rossgk/GPOD/GPOD_Stand/wdStdMake_6.jpg

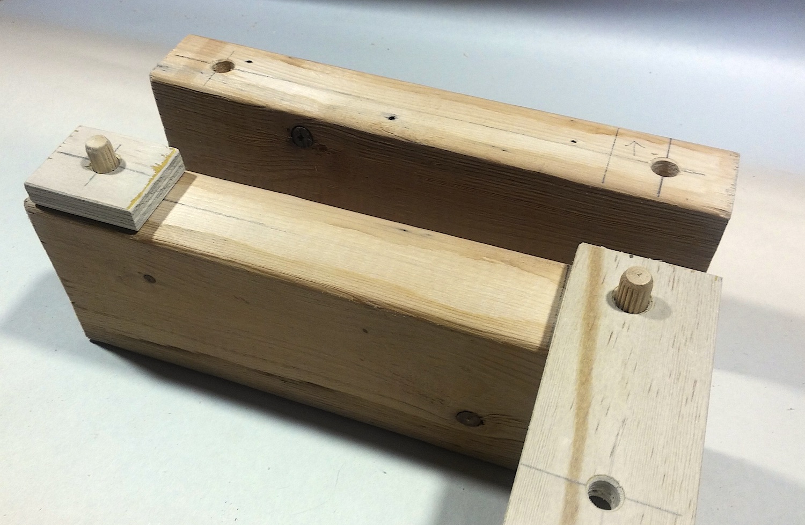
GPOD_Stand/wdStdMake_6.jpg
