rossgk/GPOD/GPOD_Stand/wdStdMake_2.jpg

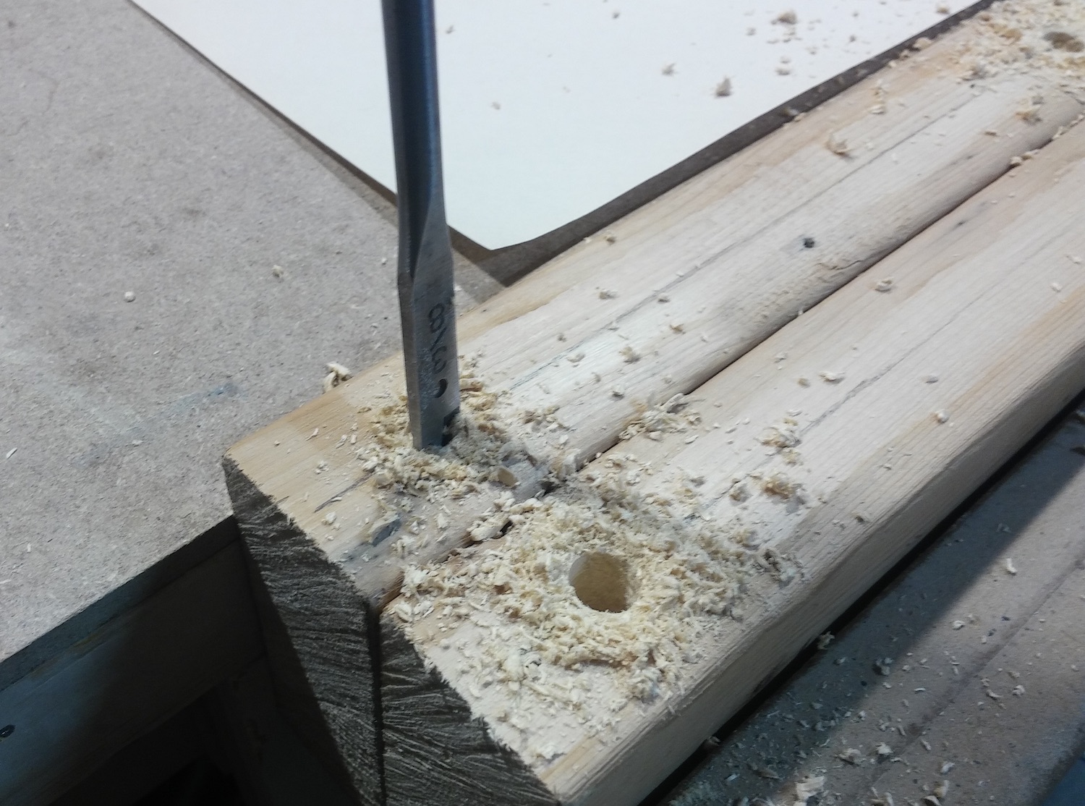
GPOD_Stand/wdStdMake_2.jpg
