rossgk/GPOD/Schem_GPOD_v1.3.pdf

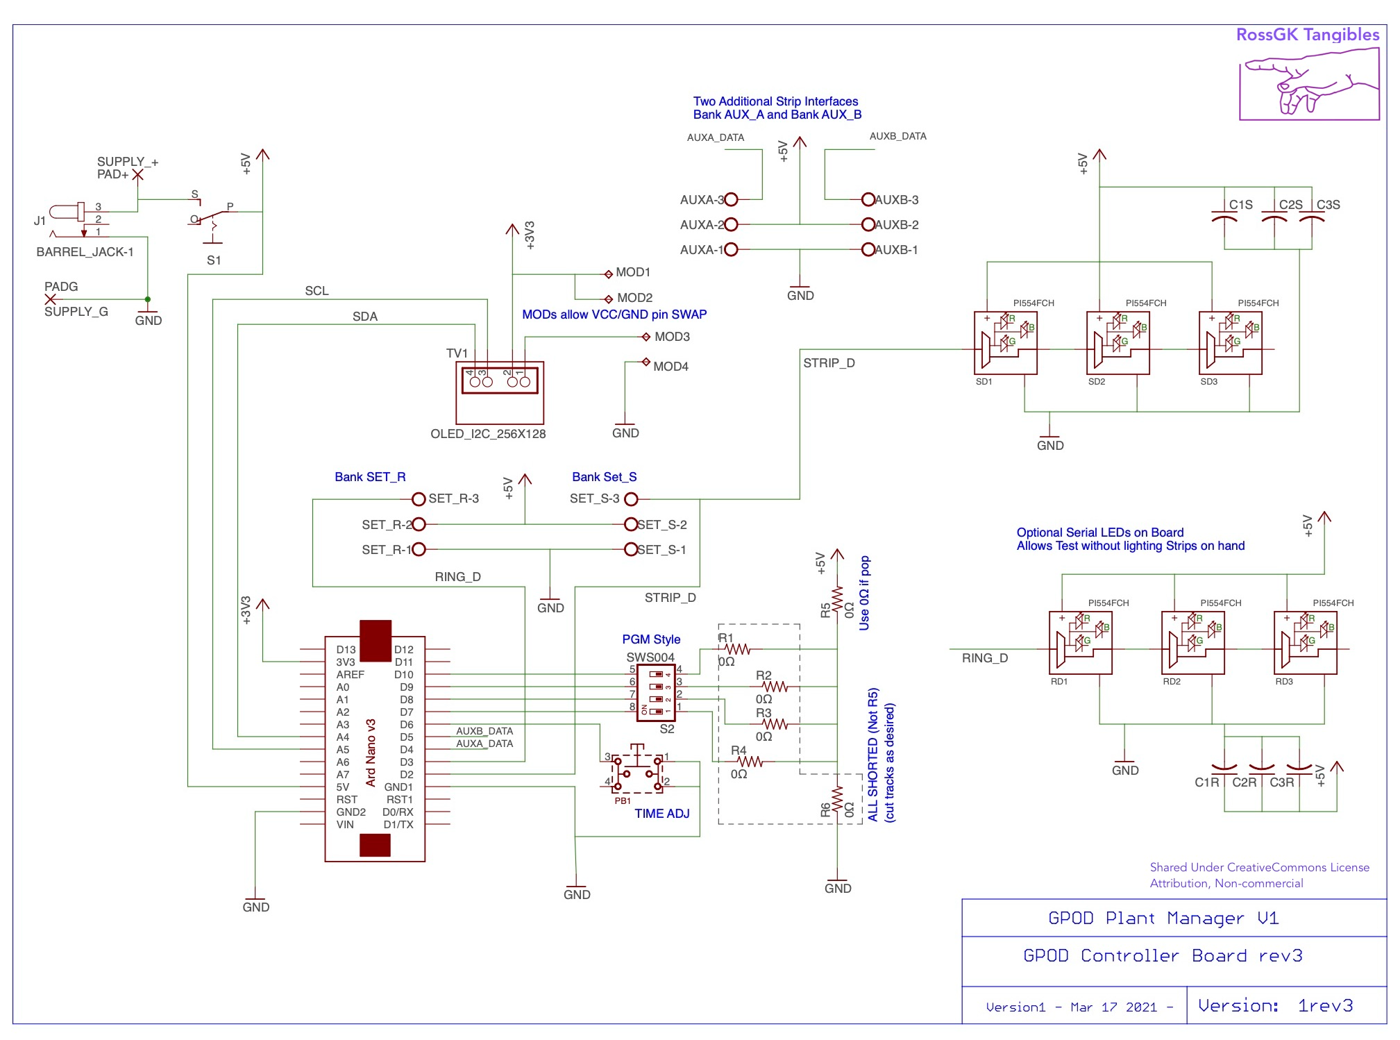
[picture p3: page 1]
