rossgk/GPOD/GPOD_Stand/wdStdMake_1.jpg

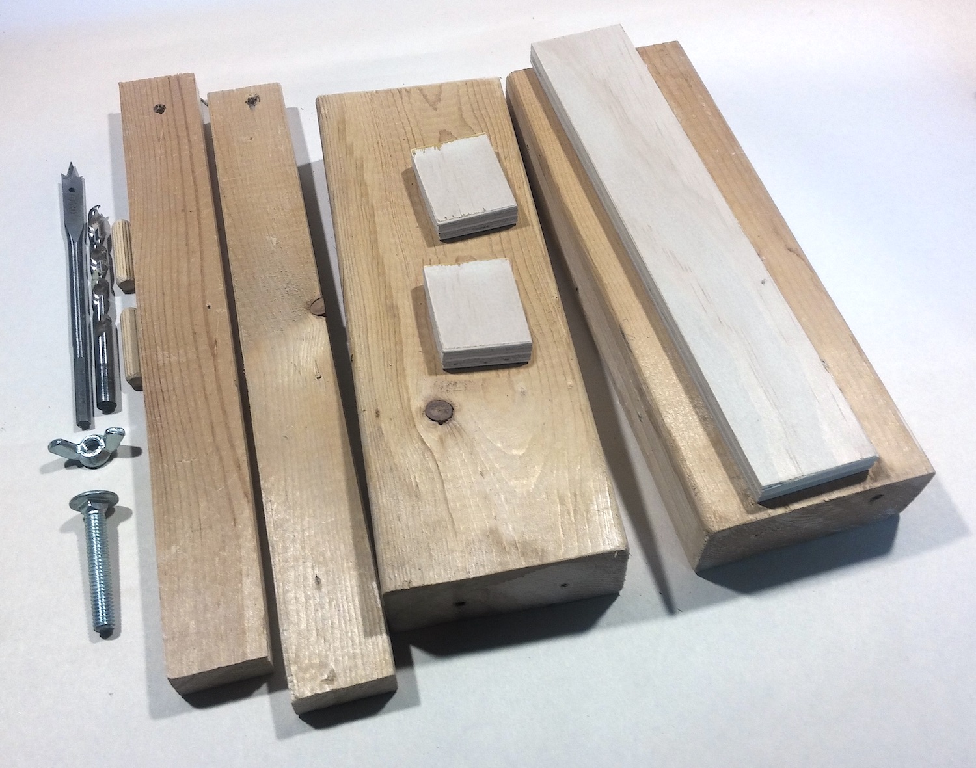
GPOD_Stand/wdStdMake_1.jpg
