rossgk/GPOD/GPOD_Stand/wdStdMake_3.jpg

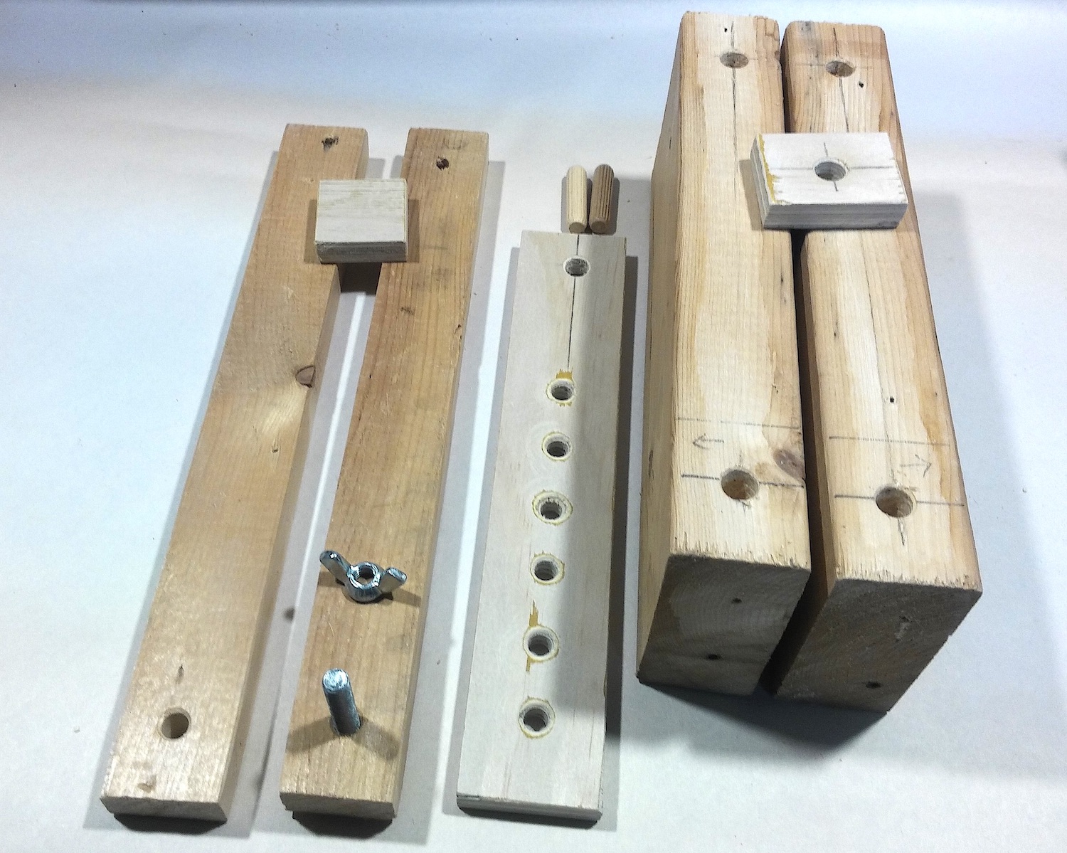
GPOD_Stand/wdStdMake_3.jpg
