rossgk/GPOD/GPOD_Stand/wdStdMake_4.jpg

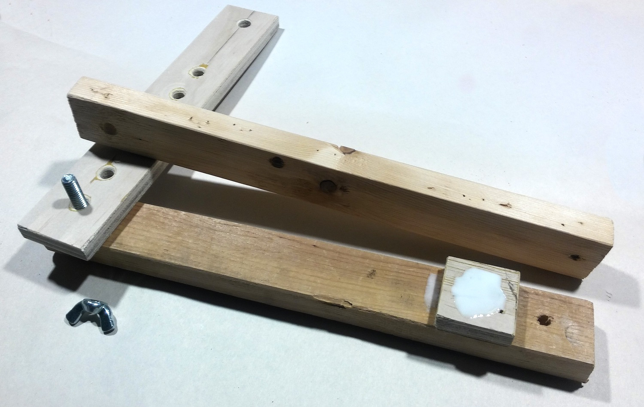
GPOD_Stand/wdStdMake_4.jpg
