rossgk/GPOD/GPOD_Stand/wdStdMake_5.jpg

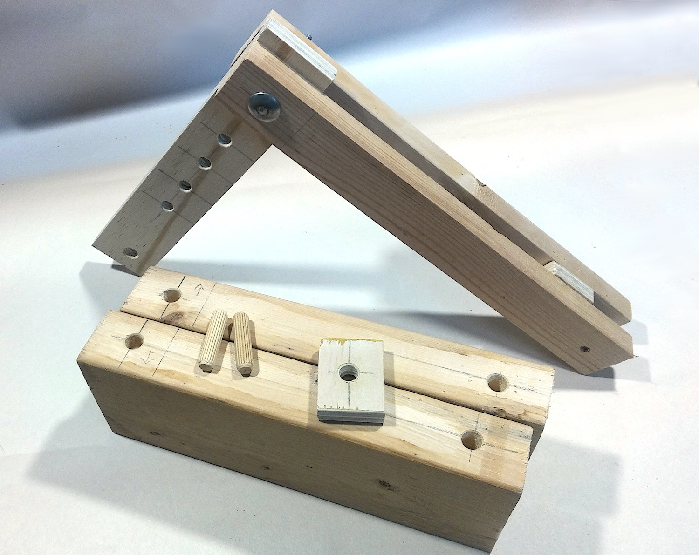
GPOD_Stand/wdStdMake_5.jpg
