rossgk/GPOD/GPOD_Stand/wdStdMake_7.jpg

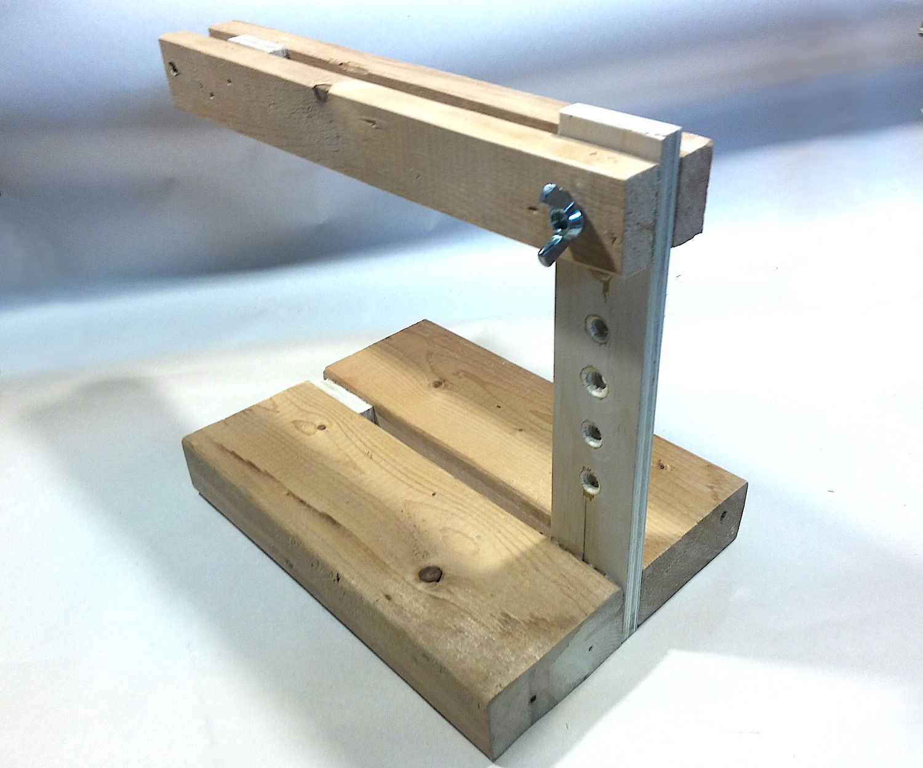
GPOD_Stand/wdStdMake_7.jpg
