rossgk/GPOD/GPOD_Stand/wdStdMake_8.jpg

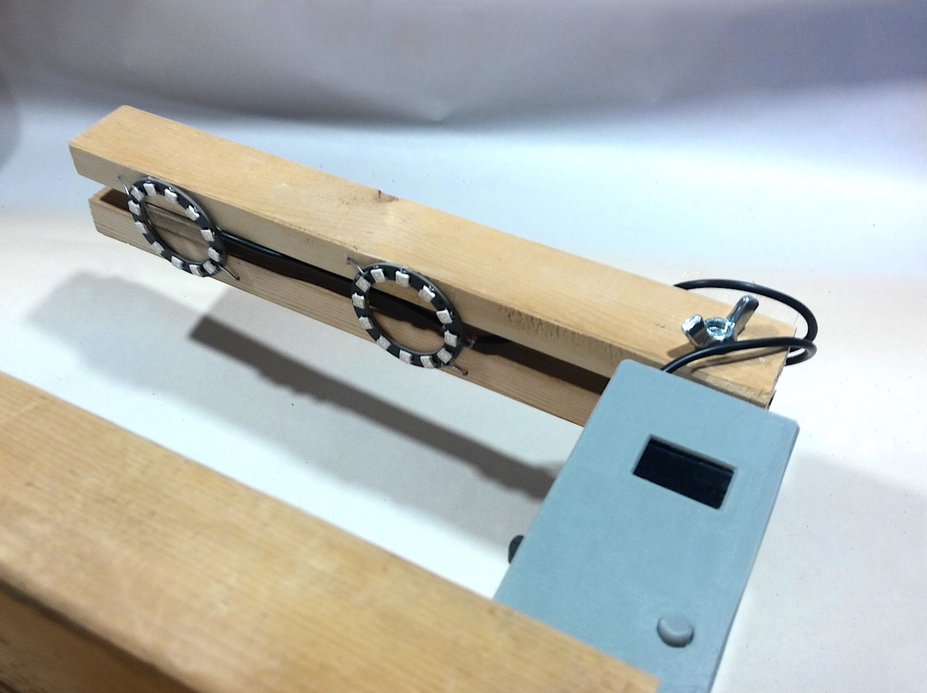
GPOD_Stand/wdStdMake_8.jpg
