rossgk/GPOD/GPOD_Stand/wdStdMake_9.jpg

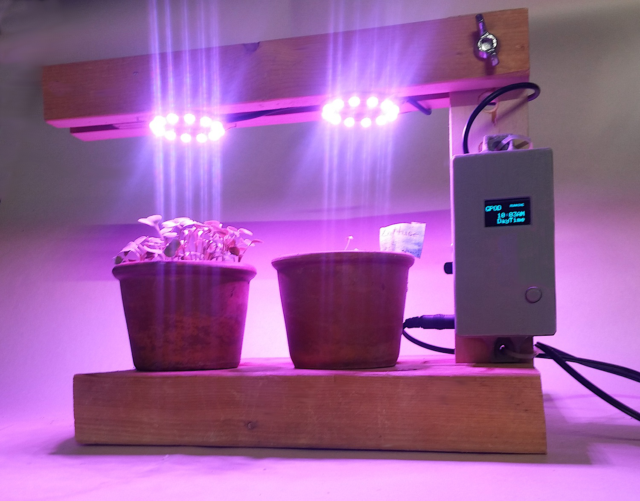
GPOD_Stand/wdStdMake_9.jpg
