rossgk/GPOD/GPOD_Stand/WdStdMake_ExplodA.jpg

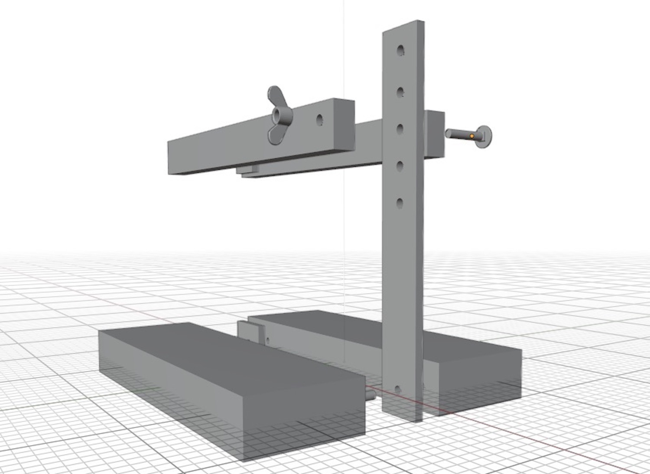
GPOD_Stand/WdStdMake_ExplodA.jpg
