rossgk/GPOD/GPOD_Stand/WdStdMake_ExplodB.jpg

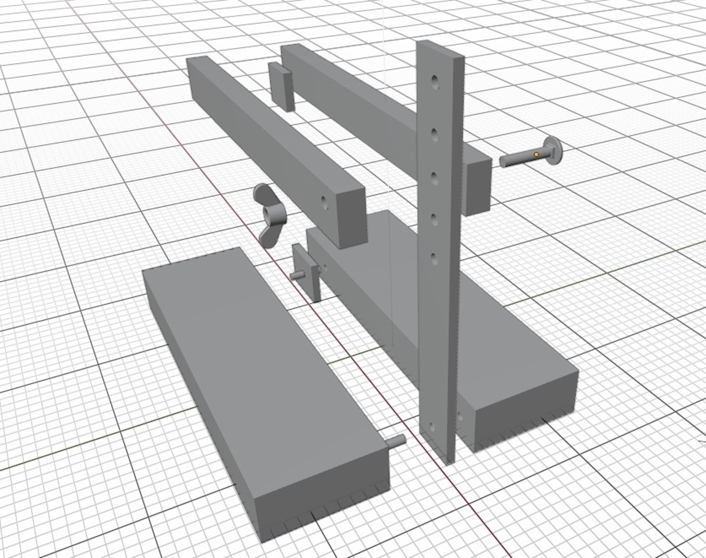
GPOD_Stand/WdStdMake_ExplodB.jpg
