rossgk/GPOD/GPOD_Stand/YogStandMake_1.jpg

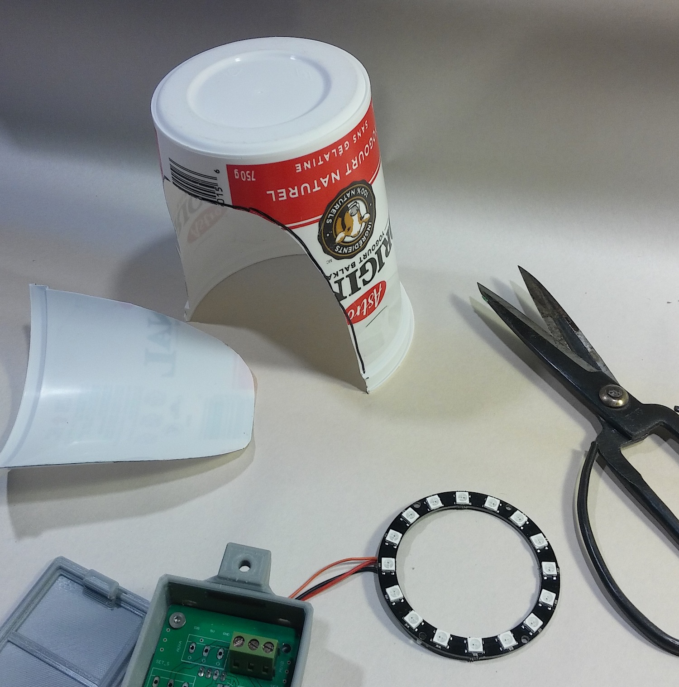
GPOD_Stand/YogStandMake_1.jpg
