rossgk/GPOD/GPOD_Stand/YogStandMake_2.png

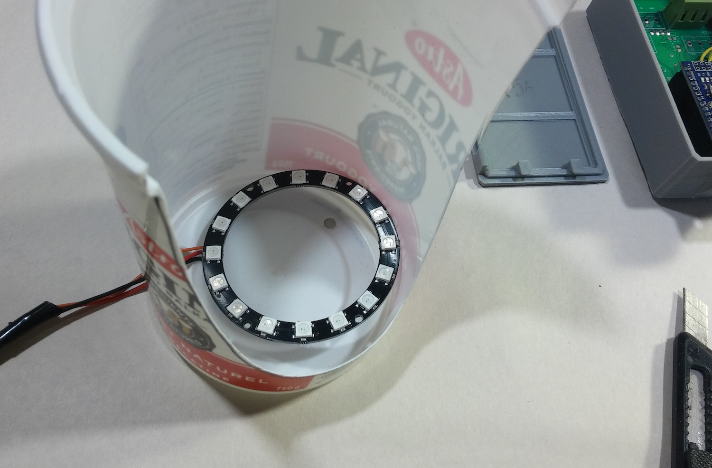
GPOD_Stand/YogStandMake_2.png
