rossgk/GPOD/GPOD_Stand/YogStandMake_3.png

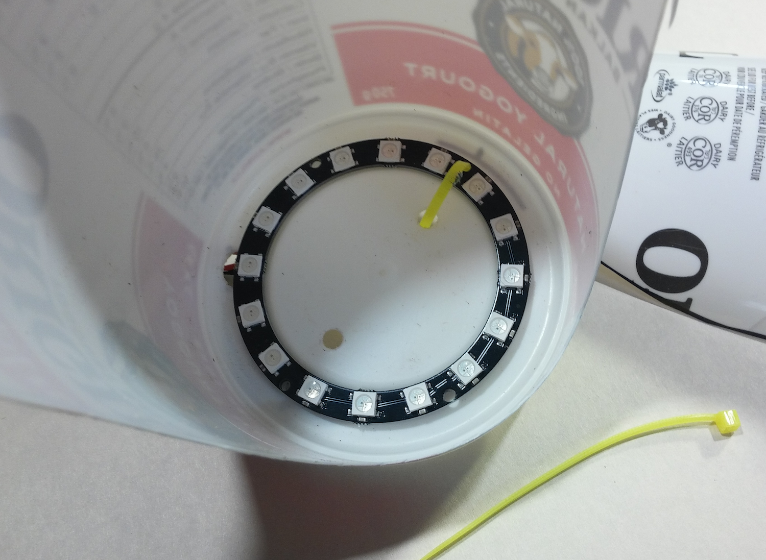
GPOD_Stand/YogStandMake_3.png
