rossgk/GPOD/GPOD_Stand/YogStandMake_4.png

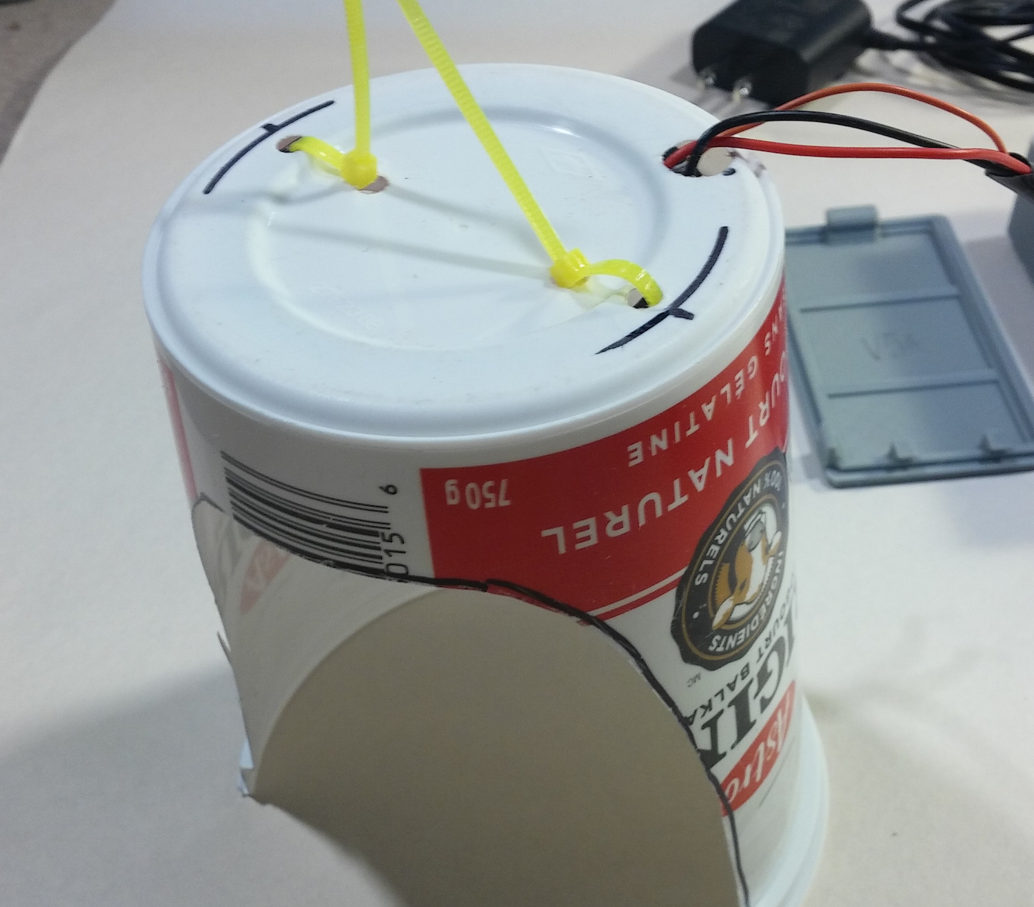
GPOD_Stand/YogStandMake_4.png
