rossgk/GPOD/GPOD_Stand/YogStandMake_5.png

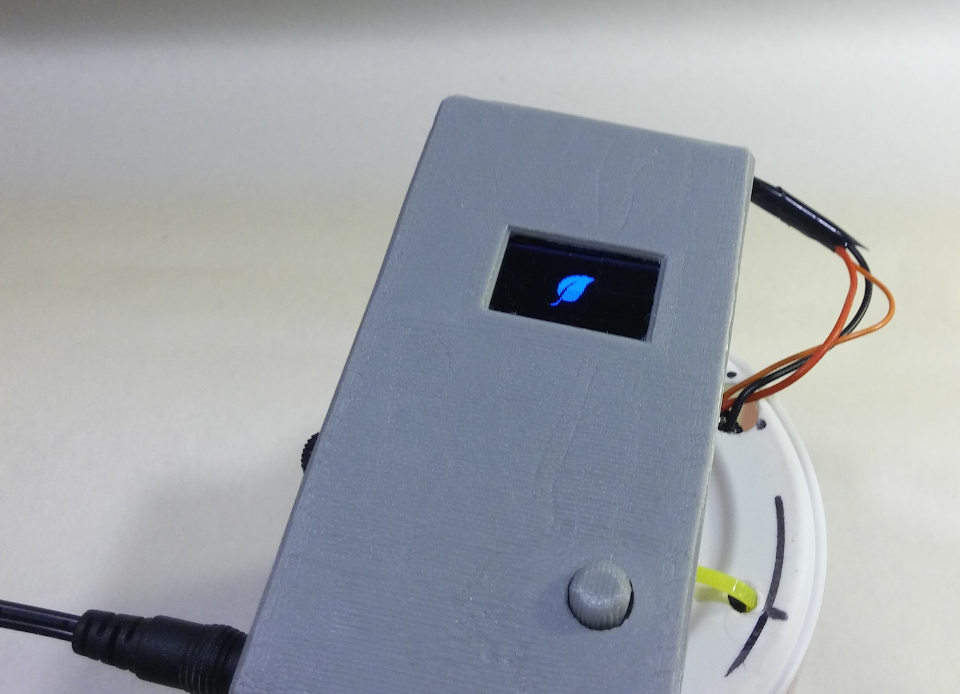
GPOD_Stand/YogStandMake_5.png
