rossgk/GPOD/GPOD_Stand/YogStandMake_6.png

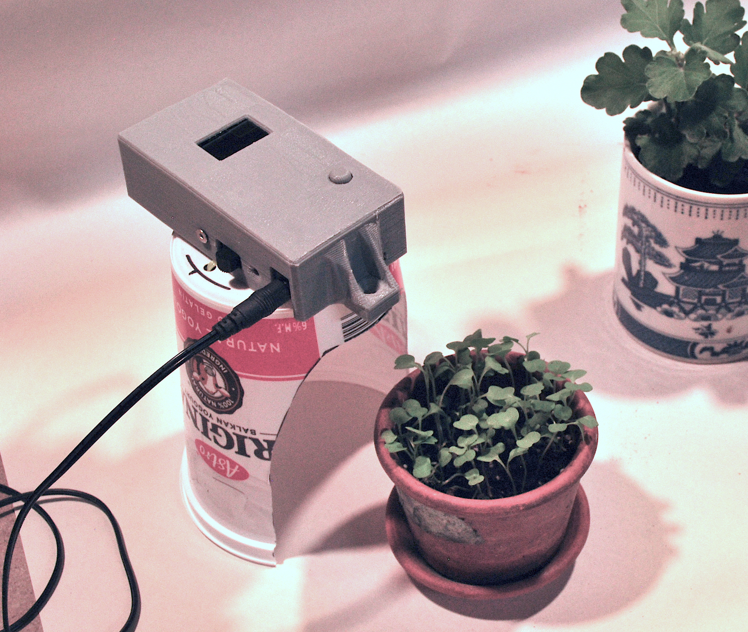
GPOD_Stand/YogStandMake_6.png
