rossgk/GPOD/GPOD_Stand/YogStandMake_7.png

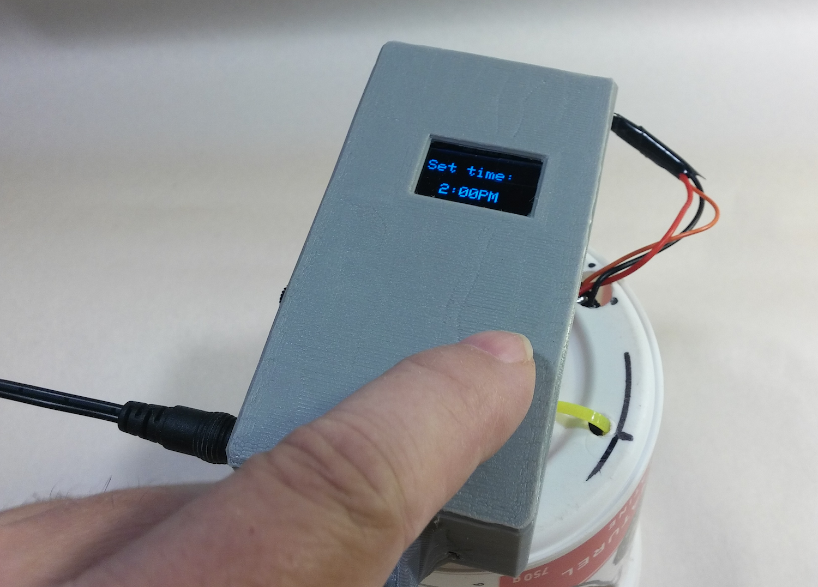
GPOD_Stand/YogStandMake_7.png
