rossgk/GPOD/GPOD_Stand/YogStandMake_8.png

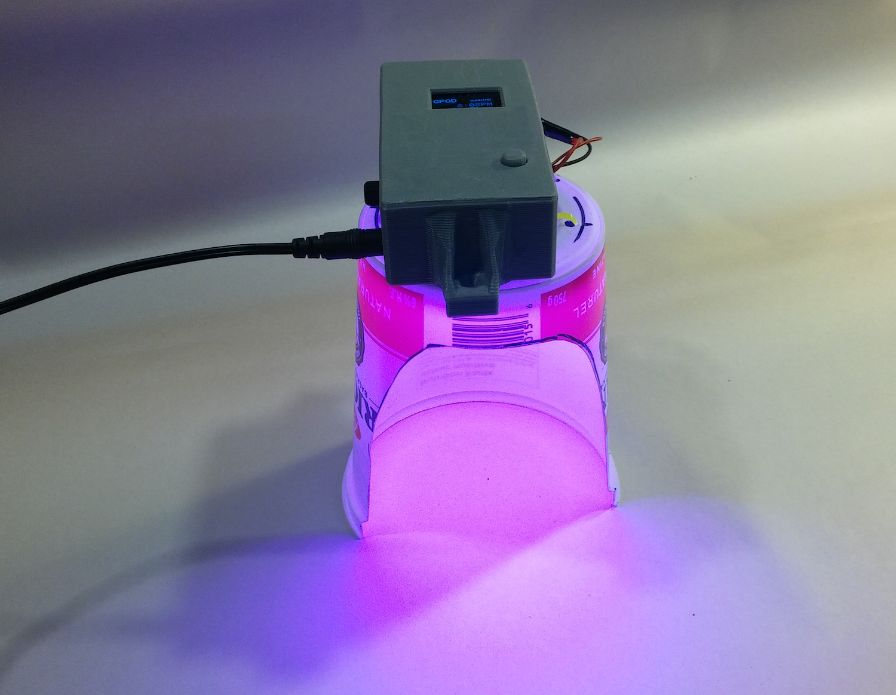
GPOD_Stand/YogStandMake_8.png
