rossgk/GPOD/GPOD_Stand/YogStandMake_9.png

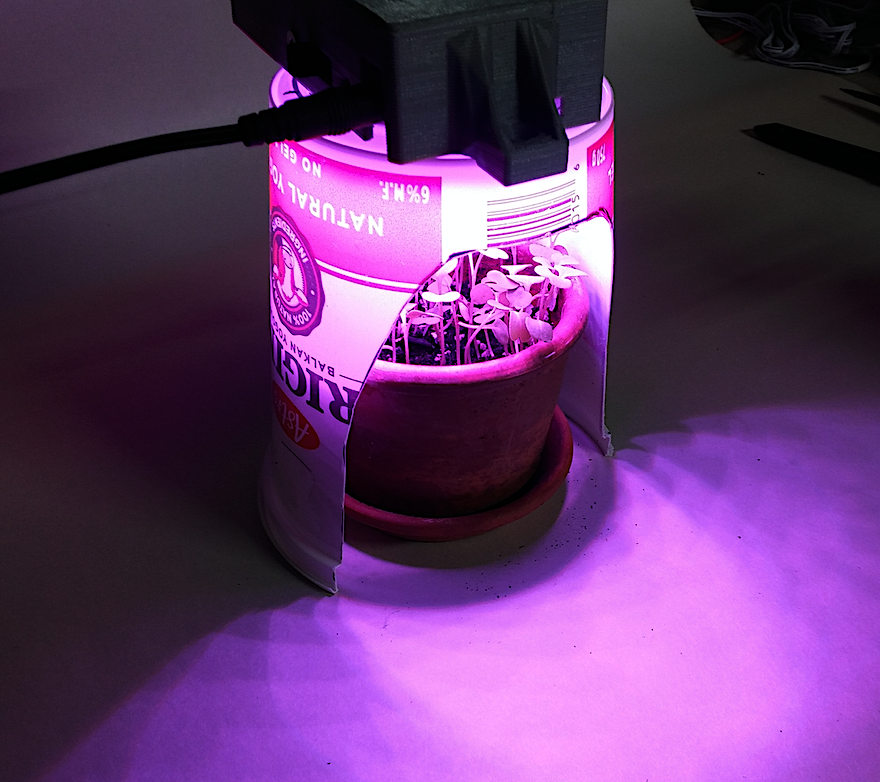
GPOD_Stand/YogStandMake_9.png
